agalakhov/klingel-external/hardware/external.kicad_pcb

## KiCad design hardware/external.kicad_pcb (2024-01-23)

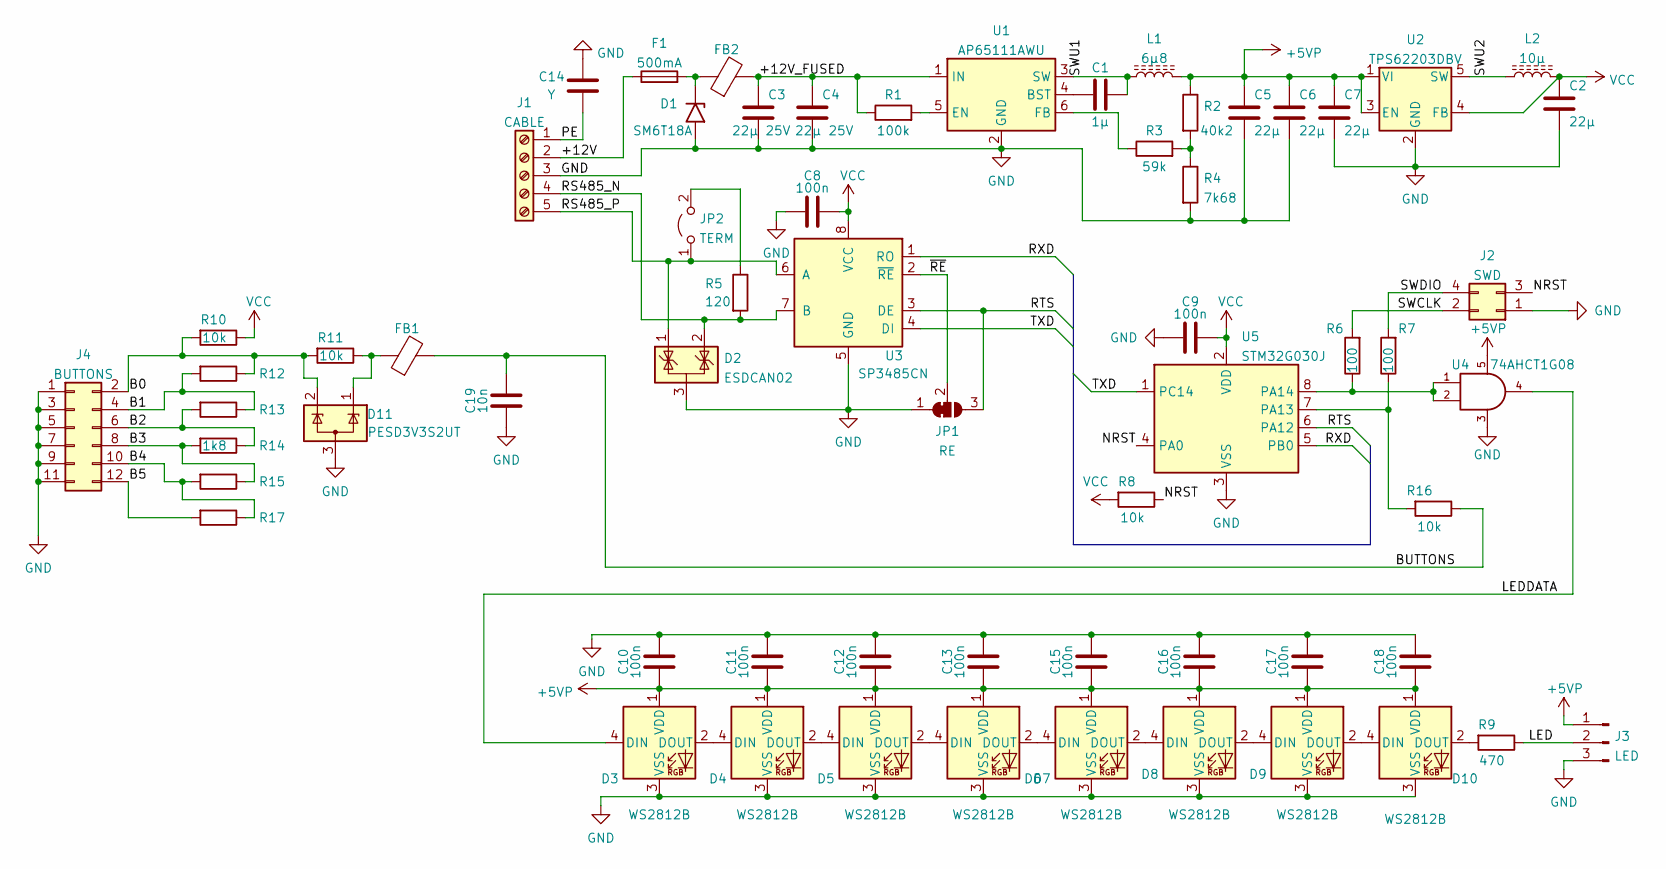
[picture p1: schematic external.kicad_sch]

Parts:
C1: 1µ; C_0805_2012Metric
C2, C5, C6, C7: 22µ; C_0805_2012Metric
C3, C4: 22µ 25V; C_0805_2012Metric
C8, C9, C10, C11, C12, C13, C15, C16, C17, C18: 100n; C_0805_2012Metric
C14: Y; C_1812_4532Metric
C19: 10n; C_0805_2012Metric
D1: SM6T18A; D_SMB
D2: ESDCAN02; SOT-23
D3, D4, D5, D6, D7, D8, D9, D10: WS2812B; LED_WS2812B_PLCC4_5.0x5.0mm_P3.2mm
D11: PESD3V3S2UT; SOT-23
F1: 500mA; Fuse_0805_2012Metric_Pad1.15x1.40mm_HandSolder
FB1, FB2: FerriteBead; L_0805_2012Metric
J1: CABLE; TerminalBlock_Phoenix_MPT-0,5-5-2.54_1x05_P2.54mm_Horizontal
J2: SWD; PinHeader_2x02_P2.54mm_Vertical
J3: LED; PinHeader_1x03_P2.54mm_Vertical
J4: BUTTONS; PinHeader_2x06_P2.54mm_Vertical
JP1: RE; SolderJumper-3_P1.3mm_Open_RoundedPad1.0x1.5mm
JP2: TERM; PinHeader_1x02_P2.54mm_Vertical
L1: 6µ8; L_Taiyo-Yuden_NR-50xx
L2: 10µ; L_Coilcraft_XxL4030
R1: 100k; R_0805_2012Metric
R2: 40k2; R_0805_2012Metric
R3: 59k; R_0805_2012Metric
R4: 7k68; R_0805_2012Metric
R5: 120; R_0805_2012Metric
R6, R7: 100; R_0805_2012Metric
R8, R10, R11, R16: 10k; R_0805_2012Metric
R9: 470; R_0805_2012Metric
R12, R13, R15, R17: R_0805_2012Metric
R14: 1k8; R_0805_2012Metric
U1: AP65111AWU; TSOT-23-6
U2: TPS62203DBV; SOT-23-5
U3: SP3485CN; SOIC-8_3.9x4.9mm_P1.27mm
U4: 74AHCT1G08; SOT-353_SC-70-5
U5: STM32G030J; SOIC-8_3.9x4.9mm_P1.27mm

Connections:
+5VP: C5.1, C6.1, C7.1, C10.1, C11.1, C12.1, C13.1, C15.1, C16.1, C17.1, C18.1, D3.1 (VDD), D4.1 (VDD), D5.1 (VDD), D6.1 (VDD), D7.1 (VDD), D8.1 (VDD), D9.1 (VDD), D10.1 (VDD), J3.1, L1.2, R2.1, U2.1 (VI), U2.3 (EN), U4.5 (VCC)
/+12V: F1.1, J1.2
/+12V_FUSED: C3.1, C4.1, FB2.2, R1.1, U1.1 (IN)
/B0: D11.2 (K), J4.2, R10.2, R11.2, R12.1
/B1: J4.4, R12.2, R13.1
/B2: J4.6, R13.2, R14.1
/B3: J4.8, R14.2, R15.1
/B4: J4.10, R15.2, R17.1
/B5: J4.12, R17.2
/BUTTONS: C19.2, FB1.2, R16.1
/LED: J3.2, R9.1
/LEDDATA: D3.4 (DIN), U4.4
/NRST: J2.3, R8.1, U5.4 (PA0)
/PE: C14.2, J1.1
/RS485_N: D2.2 (K), J1.4, R5.2, U3.7 (B)
/RS485_P: D2.1 (K), J1.5, JP2.1 (A), U3.6 (A)
/RTS: JP1.3 (B), U3.3 (DE), U5.6 (PA12)
/RXD: U3.1 (RO), U5.5 (PB0)
/SWCLK: J2.2, R6.2
/SWDIO: J2.4, R7.2
/SWU1: C1.2, L1.1, U1.3 (SW)
/SWU2: L2.1, U2.5 (SW)
/TXD: U3.4 (DI), U5.1 (PC14)
/~RE: JP1.2 (C), U3.2 (~RE)
GND: C2.2, C3.2, C4.2, C5.2, C6.2, C7.2, C8.1, C9.1, C10.2, C11.2, C12.2, C13.2, C14.1, C15.2, C16.2, C17.2, C18.2, C19.1, D1.2 (A2), D2.3 (A), D3.3 (VSS), D4.3 (VSS), D5.3 (VSS), D6.3 (VSS), D7.3 (VSS), D8.3 (VSS), D9.3 (VSS), D10.3 (VSS), D11.3 (A), J1.3, J2.1, J3.3, J4.1, J4.3, J4.5, J4.7, J4.9, J4.11, JP1.1 (A), R4.2, U1.2 (GND), U2.2 (GND), U3.5 (GND), U4.3 (GND), U5.3 (VSS)
unnamed: C1.1, U1.4 (BST)
unnamed: D1.1 (A1), F1.2, FB2.1
unnamed: D3.2 (DOUT), D4.4 (DIN)
unnamed: D4.2 (DOUT), D5.4 (DIN)
unnamed: D5.2 (DOUT), D6.4 (DIN)
unnamed: D6.2 (DOUT), D7.4 (DIN)
unnamed: D7.2 (DOUT), D8.4 (DIN)
unnamed: D8.2 (DOUT), D9.4 (DIN)
unnamed: D10.2 (DOUT), R9.2
unnamed: D9.2 (DOUT), D10.4 (DIN)
unnamed: D11.1 (K), FB1.1, R11.1
unnamed: JP2.2 (B), R5.1
unnamed: R1.2, U1.5 (EN)
unnamed: R2.2, R3.2, R4.1
unnamed: R3.1, U1.6 (FB)
unnamed: R6.1, U4.1, U4.2, U5.8 (PA14)
unnamed: R7.1, R16.2, U5.7 (PA13)
VCC: C2.1, C8.2, C9.2, L2.2, R8.2, R10.1, U2.4 (FB), U3.8 (VCC), U5.2 (VDD)

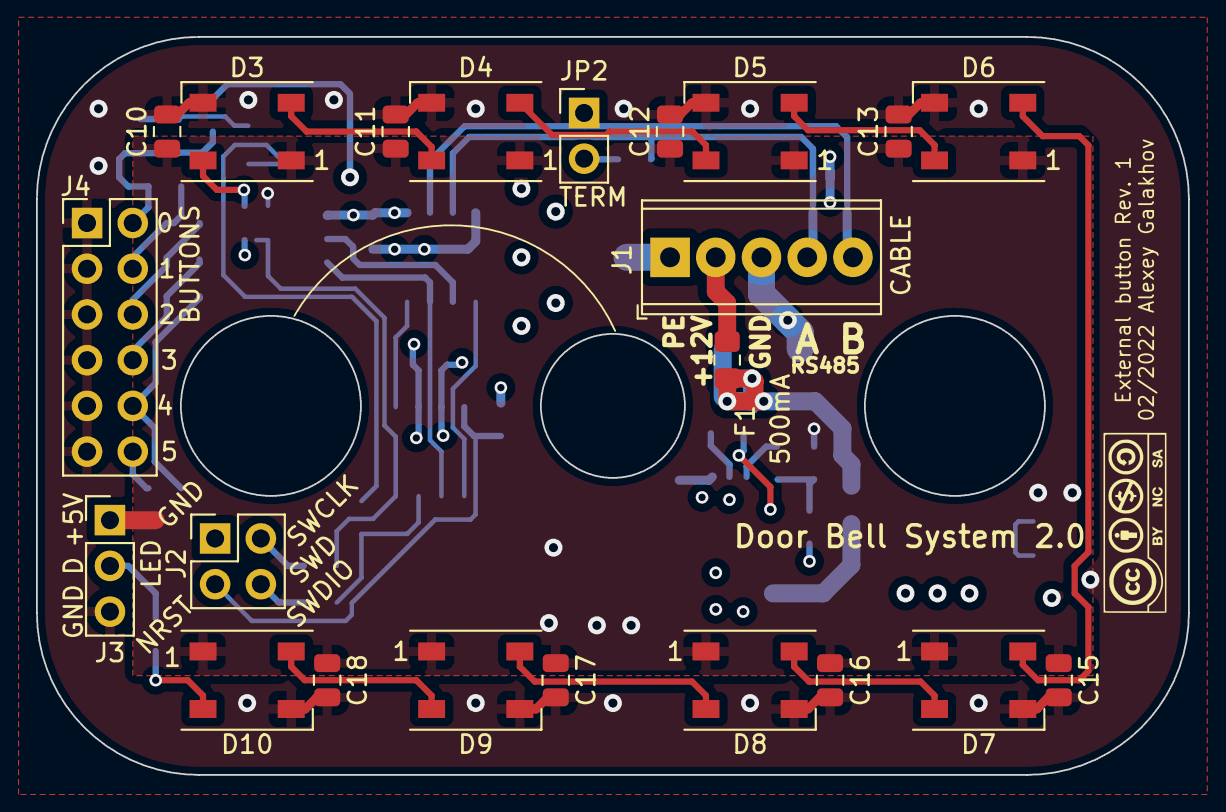
[picture p2: board external.kicad_pcb from above]

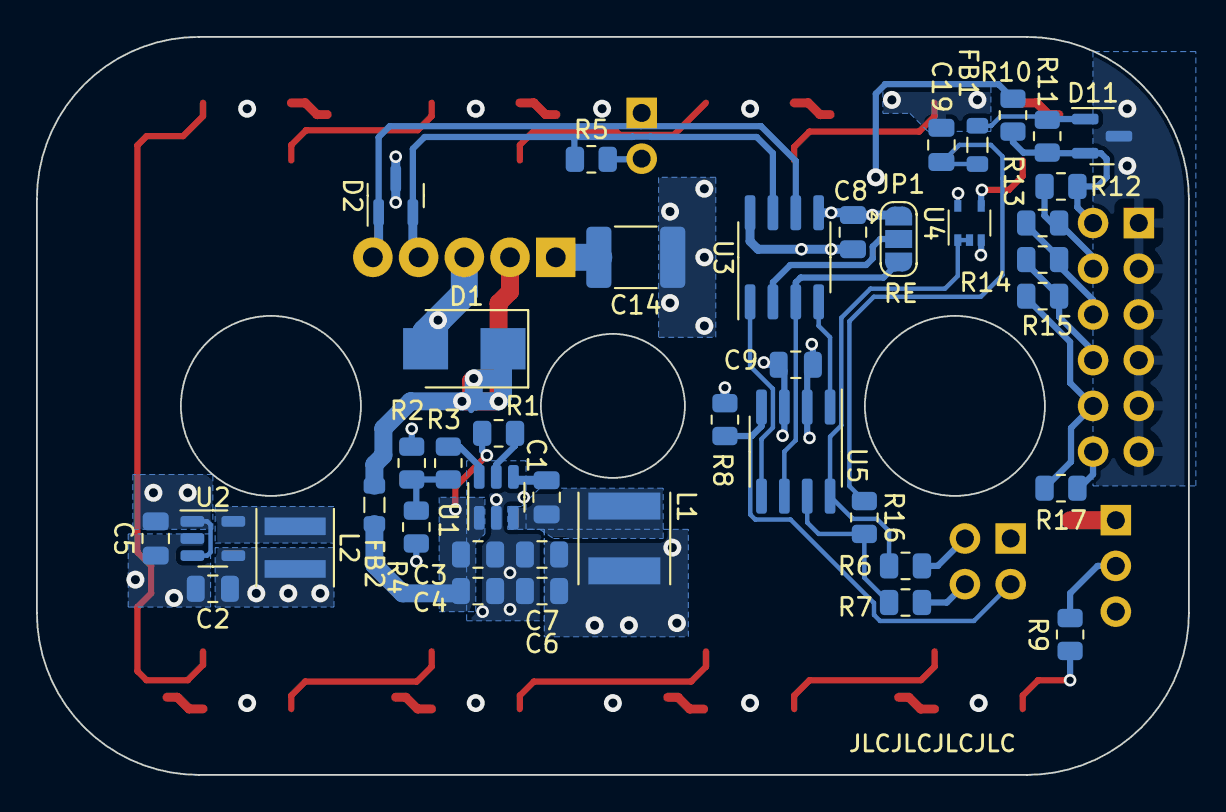
[picture p3: board external.kicad_pcb from below]

Board: 4 copper layers, 64.0 x 41.0 mm, 63 parts (41 on the bottom side), 43 nets.
