agalakhov/klingel-external/(commit log)

2022-10-01 Working version, DMA not guarded, no CRC check
2022-10-15 led: support intensity scaling and glowing
2022-10-15 led: correct blinking periods
    [app.rs, led.rs]
2022-10-15 led: add one-time effects
2022-10-15 led: support effects
2022-10-15 led: rework dirty state
    [app.rs, led.rs]
2022-10-15 led: correct effects
2023-10-21 rs485: fix intensity handling
    [command.rs]
2023-11-04 rs485: swap A and B pins
    [app.rs]
2023-11-06 rs485: handle bus collisions
    [rs485.rs]
2023-11-07 rs485: stop processing at error detection
    [rs485.rs]
2024-01-23 Add hardware project
    [external.kicad_pcb, external.kicad_sch]
